jcnossen/dmf/README.md

# dmf
Prototype for electrowetting and digital microfluidics
