jcnossen/dmf/dmf.brd

## EAGLE design dmf.brd (2015-10-09)

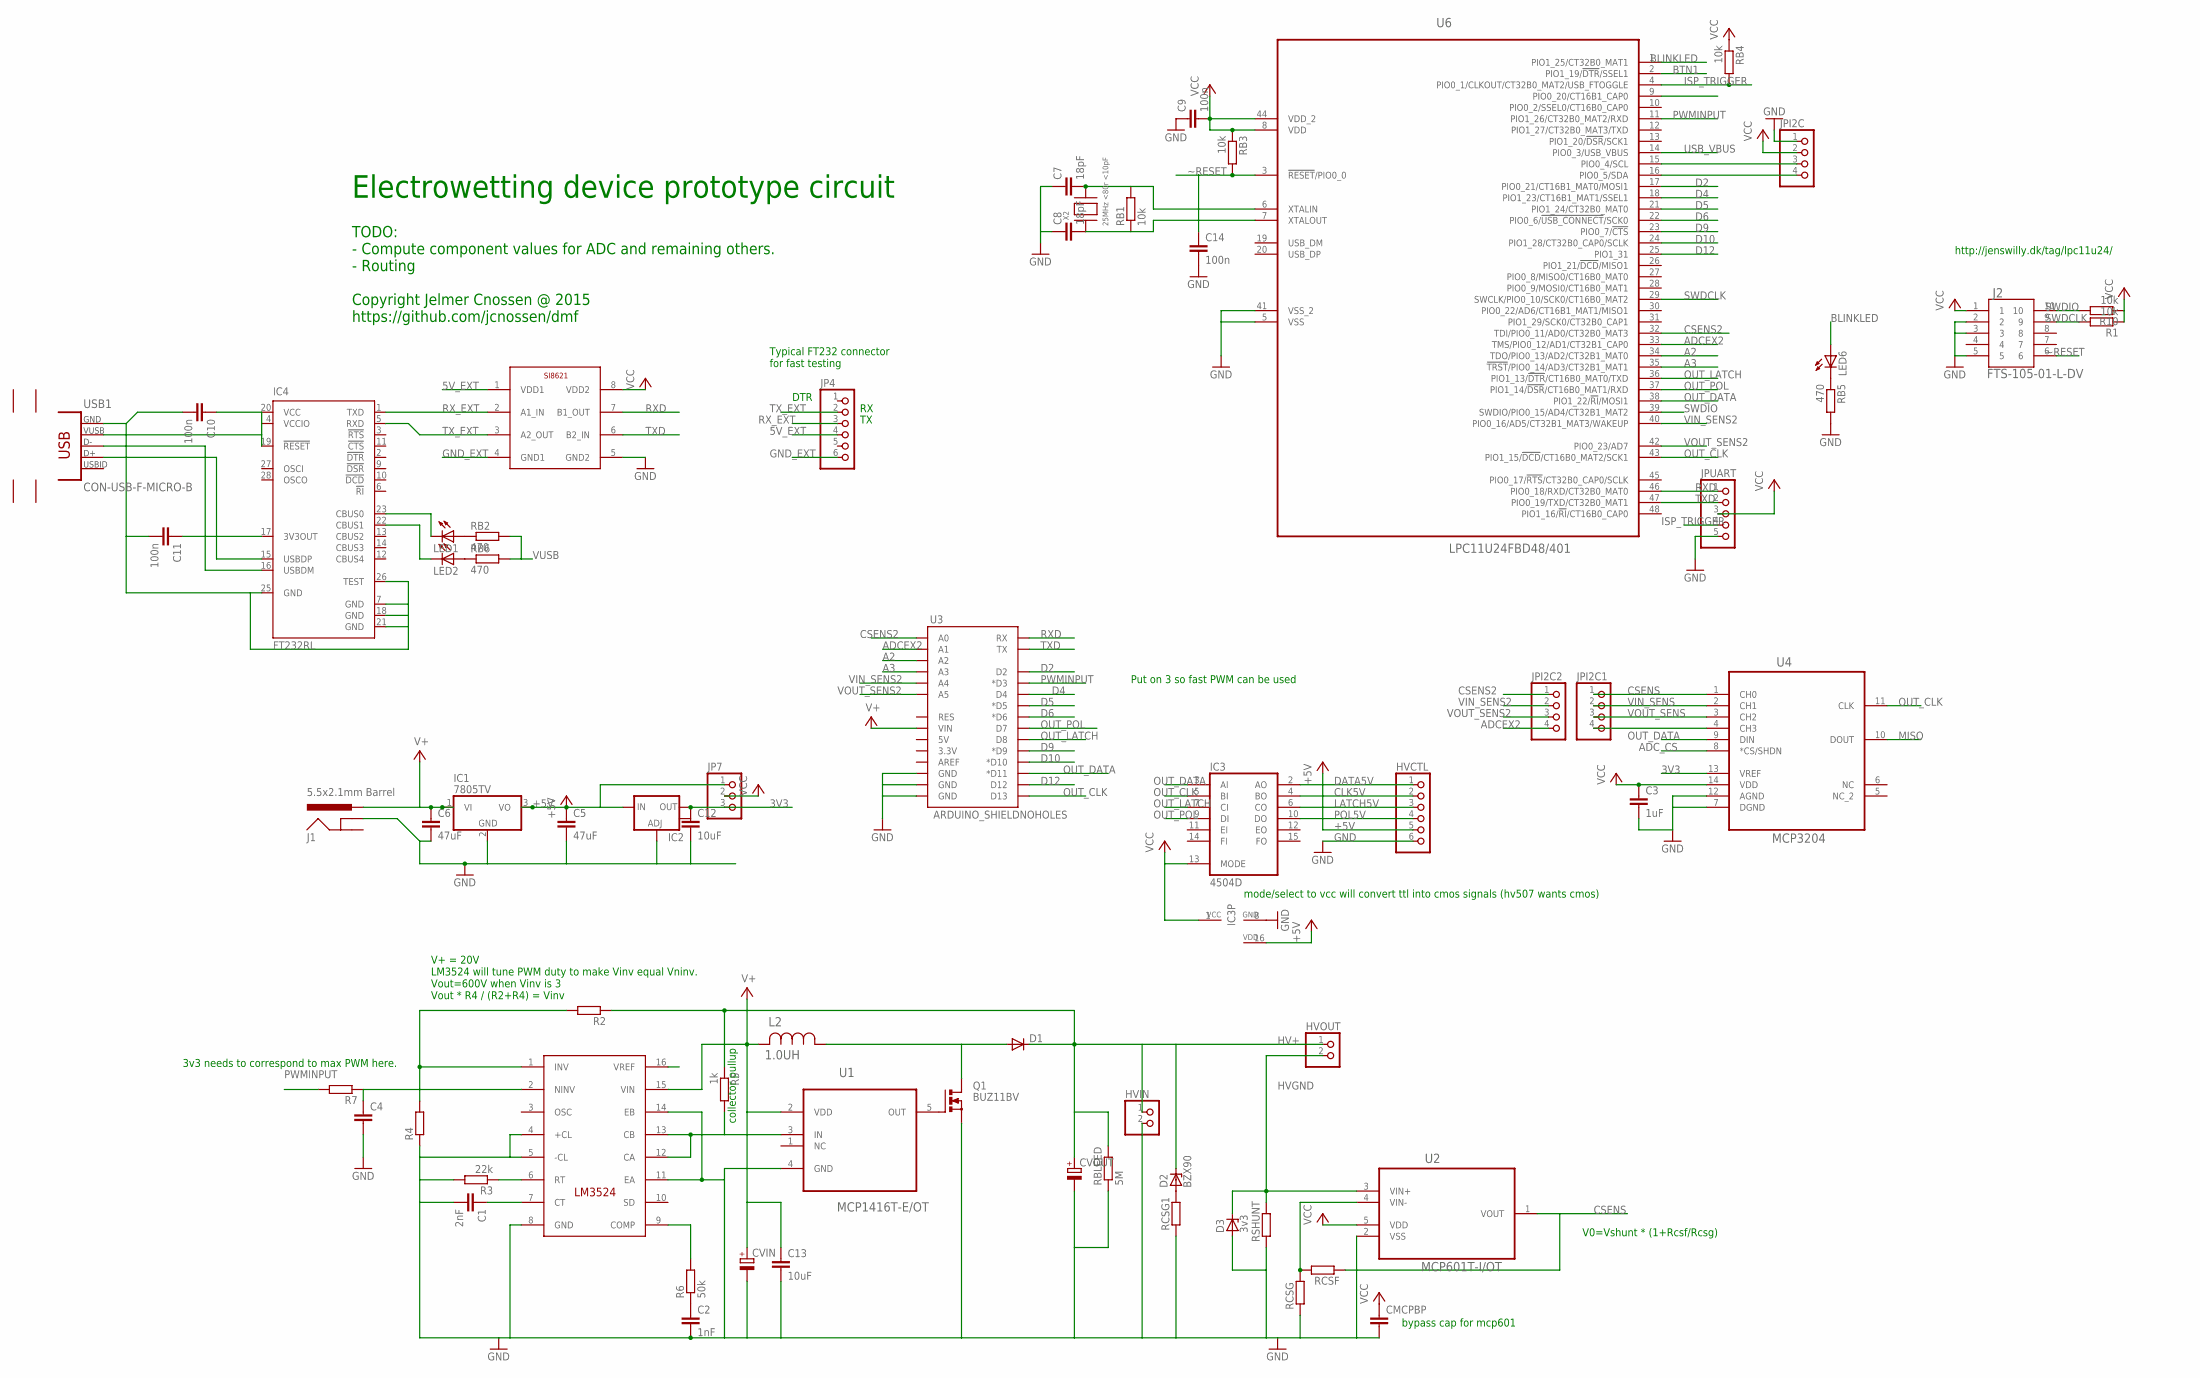
[picture p1: schematic dmf.sch, sheet 1]

Parts:
C1: 2nF; C0805
C2: 1nF; C0805
C3: 1uF; C0805
C4: C-EUC0805; C0805
C5, C6: 47uF; C1206
C7, C8: 18pF; C0805
C9, C10, C11, C14: 100n; C0805
C12: 10uF; C1206
C13: 10uF; C0805
CMCPBP: C-EUC0805; C0805
CVIN: CPOL-EUE7.5-18; E7,5-18
CVOUT: CPOL-EUE7.5-18; E7,5-18
D1: DIODE-SMB; SMB
D2: BZX90; DO34Z7
D3: 3v3; SMB
HVCTL: PINHD-1X06_2.54-S; 1X06-S
HVIN: PINHD-1X02_2.54; 1X02
HVOUT: PINHD-1X02_2.54; 1X02
IC1: 7805TV; TO220V
IC2: V_REG_LM1117SOT223; SOT223
IC3: 4504D; SO16
IC4: FT232RL; SSOP28
J1: 5.5x2.1mm Barrel; POWER_JACK_SMD
J2: FTS-105-01-L-DV; SAMTEC_FTS-105-01-L-DV
JP4: PINHD-1X06_2.54-S; 1X06-S
JP7: PINHD-1X03_2.54-S; 1X03-S
JPI2C, JPI2C1, JPI2C2: PINHD-1X04_2.54-S; 1X04-S
JPUART: PINHD-1X05_2.54-S; 1X05-S
L2: 1.0UH; IND_ELL6XH
LED1, LED2, LED6: LEDCHIP-LED0805; CHIP-LED0805
Q1: BUZ11BV; TO220BV
R1, R10: 10k; R0603
R2, R4, R7: R-EU_R0603; R0603
R3: 22k; R0603
R5: 1k; R0603
R6: 50k; R0603
RB1, RB3, RB4: 10k; R0603
RB2, RB6: 470; R0603
RB5: 470; R0402
RBLEED: 5M; R1206
RCSF: R-EU_R0603; R0603
RCSG: R-EU_R0603; R0603
RCSG1: R-EU_R1206; R1206
RSHUNT: R-EU_R1206; R1206
U1: MCP1416T-E/OT; SOT95P270X145-5N
U2: MCP601T-I/OT; SOT95P320X145-5N
U3: ARDUINO_SHIELDNOHOLES; DUEMILANOVE_SHIELD_NOHOLES
U4: MCP3204; SOIC127P600X175-14N
U6: LPC11U24FBD48/401; QFP50P900X900X160-48N
U$1: LM3524; SO16
U$2: SI8621AB; SO8
USB1: CON-USB-F-MICRO-B; CONN_USB_MICRO-B
X2: 25MHz <80r <10pF; NX5032

Connections:
3V3: C12.1, IC2.2 (OUT), JP7.3, U4.13 (VREF)
5V_EXT: JP4.4, U$2.1 (VDD1)
+5V: C5.1, HVCTL.5, IC1.3 (VO), IC2.3 (IN), IC3.16 (VDD), JP7.1
A2: U3.A2, U6.34 (TDO/PIO0_13/AD2/CT32B1_MAT0)
A3: U3.A3, U6.35 (!TRST!/PIO0_14/AD3/CT32B1_MAT1)
ADCEX: JPI2C1.4, U4.4 (CH3)
ADCEX2: JPI2C2.4, U3.A1, U6.33 (TMS/PIO0_12/AD1/CT32B1_CAP0)
ADC_CS: U4.8 (*CS/SHDN)
BLINKLED: LED6.A, U6.1 (PIO1_25/CT32B0_MAT1)
BTN1: U6.2 (PIO1_19/!DTR!/SSEL1)
CLK5V: HVCTL.2, IC3.4 (BO)
COLLECTOR: R5.2, U1.3 (IN), U$1.12 (CA), U$1.13 (CB)
CSENS: JPI2C1.1, RCSF.1, U2.1 (VOUT), U4.1 (CH0)
CSENS2: JPI2C2.1, U3.A0, U6.32 (TDI/PIO0_11/AD0/CT32B0_MAT3)
D2: U3.D2, U6.17 (PIO0_21/CT16B1_MAT0/MOSI1)
D4: U3.D4, U6.18 (PIO1_23/CT16B1_MAT1/SSEL1)
D5: U3.D5 (*D5), U6.21 (PIO1_24/CT32B0_MAT0)
D6: U3.D6 (*D6), U6.22 (PIO0_6/!USB_CONNECT!/SCK0)
D9: U3.D9 (*D9), U6.23 (PIO0_7/!CTS)
D10: U3.D10 (*D10), U6.24 (PIO1_28/CT32B0_CAP0/SCLK)
D12: U3.D12, U6.25 (PIO1_31)
DATA5V: HVCTL.1, IC3.2 (AO)
GND: C1.2, C2.2, C3.2, C4.2, C5.2, C6.2, C7.1, C8.1, C9.1, C12.2, C13.2, C14.2, CMCPBP.2, CVIN.-, CVOUT.-, D3.A, HVCTL.6, HVIN.2, IC1.2 (GND), IC2.1 (ADJ), IC3.8 (GND), J1.GND (GNDBREAK), J2.2, J2.3, J2.5, JPI2C.1, JPUART.5, Q1.S, R3.2, R4.1, RB5.2, RBLEED.1, RCSG.1, RCSG1.1, RSHUNT.1, U1.4 (GND), U2.2 (VSS), U3.GND@0 (GND), U3.GND@1 (GND), U3.GND@2 (GND), U4.7 (DGND), U4.12 (AGND), U6.5 (VSS), U6.41 (VSS_2), U$1.4 (+CL), U$1.5 (-CL), U$1.8 (GND), U$1.11 (EA), U$1.14 (EB), U$2.5 (GND2)
GND_EXT: C10.2, C11.2, IC4.7 (GND), IC4.18 (GND), IC4.21 (GND), IC4.25 (GND), IC4.26 (TEST), JP4.6, U$2.4 (GND1), USB1.P5 (GND)
HV+: CVOUT.+, D1.C, D2.C, HVIN.1, HVOUT.1, R2.1, R5.1, RBLEED.2
HVGND: D3.C, HVOUT.2, RSHUNT.2, U2.3 (VIN+)
ISP_TRIGGER: JPUART.4, RB4.2, U6.4 (PIO0_1/CLKOUT/CT32B0_MAT2/USB_FTOGGLE)
LATCH5V: HVCTL.3, IC3.6 (CO)
MISO: U4.10 (DOUT)
unnamed: C2.1, R6.1
unnamed: C1.1, U$1.7 (CT)
unnamed: R2.2, R4.2, U$1.1 (INV)
unnamed: R3.1, U$1.6 (RT)
unnamed: R6.2, U$1.9 (COMP)
unnamed: D1.A, L2.1, Q1.D
unnamed: Q1.G, U1.5 (OUT)
unnamed: RCSF.2, RCSG.2, U2.4 (VIN-)
unnamed: D2.A, RCSG1.2
unnamed: C4.1, R7.1, U$1.2 (NINV)
unnamed: IC4.16 (USBDM), USB1.P2 (D-)
unnamed: IC4.15 (USBDP), USB1.P3 (D+)
unnamed: C11.1, IC4.17 (3V3OUT)
unnamed: IC4.23 (CBUS0), LED1.C
unnamed: IC4.22 (CBUS1), LED2.C
unnamed: LED1.A, RB2.1
unnamed: LED2.A, RB6.1
unnamed: C8.2, RB1.1, U6.7 (XTALOUT), X2.P$1
unnamed: LED6.C, RB5.1
unnamed: C7.2, RB1.2, U6.6 (XTALIN), X2.P$2
OUT_CLK: IC3.5 (BI), U3.D13, U4.11 (CLK), U6.43 (PIO1_15/!DCD!/CT16B0_MAT2/SCK1)
OUT_DATA: IC3.3 (AI), U3.D11 (*D11), U4.9 (DIN), U6.38 (PIO1_22/!RI!/MOSI1)
OUT_LATCH: IC3.7 (CI), U3.D8, U6.36 (PIO1_13/!DTR!/CT16B0_MAT0/TXD)
OUT_POL: IC3.9 (DI), U3.D7, U6.37 (PIO1_14/!DSR!/CT16B0_MAT1/RXD)
POL5V: HVCTL.4, IC3.10 (DO)
PWMINPUT: R7.2, U3.D3 (*D3), U6.11 (PIO1_26/CT32B0_MAT2/RXD)
RXD: JPUART.1, U3.RX, U6.46 (PIO0_18/RXD/CT32B0_MAT0), U$2.7 (B1_OUT)
RX_EXT: IC4.1 (TXD), JP4.3, U$2.2 (A1_IN)
SCL: JPI2C.3, U6.15 (PIO0_4/SCL)
SDA: JPI2C.4, U6.16 (PIO0_5/SDA)
SWDCLK: J2.9, R1.2, U6.29 (SWCLK/PIO0_10/SCK0/CT16B0_MAT2)
SWDIO: J2.10, R10.2, U6.39 (SWDIO/PIO0_15/AD4/CT32B1_MAT2)
TXD: JPUART.2, U3.TX, U6.47 (PIO0_19/TXD/CT32B0_MAT1), U$2.6 (B2_IN)
TX_EXT: IC4.5 (RXD), JP4.2, U$2.3 (A2_OUT)
USB_VBUS: U6.14 (PIO0_3/USB_VBUS)
V+: C6.1, C13.1, CVIN.+, IC1.1 (VI), J1.VIN0 (PWR), L2.2, U1.2 (VDD), U3.VIN, U$1.15 (VIN)
VCC: C3.1, C9.2, CMCPBP.1, IC3.1 (VCC), IC3.13 (MODE), J2.1, JP7.2, JPI2C.2, JPUART.3, R1.1, R10.1, RB3.1, RB4.1, U2.5 (VDD), U4.14 (VDD), U6.8 (VDD), U6.44 (VDD_2), U$2.8 (VDD2)
VIN_SENS: JPI2C1.2, U4.2 (CH1)
VIN_SENS2: JPI2C2.2, U3.A4, U6.40 (PIO0_16/AD5/CT32B1_MAT3/WAKEUP)
VOUT_SENS: JPI2C1.3, U4.3 (CH2)
VOUT_SENS2: JPI2C2.3, U3.A5, U6.42 (PIO0_23/AD7)
VUSB: C10.1, IC4.4 (VCCIO), IC4.19 (!RESET), IC4.20 (VCC), RB2.2, RB6.2, USB1.P1 (VUSB)
~RESET: C14.1, J2.6, RB3.2, U6.3 (!RESET!/PIO0_0)

Notes on the sheet:
V0=Vshunt * (1+Rcsf/Rcsg)
bypass cap for mcp601
V+ = 20V LM3524 will tune PWM duty to make Vinv equal Vninv. Vout=600V when Vinv is 3 Vout * R4 / (R2+R4) = Vinv
3v3 needs to correspond to max PWM here.
Put on 3 so fast PWM can be used
mode/select to vcc will convert ttl into cmos signals (hv507 wants cmos)
DTR
Typical FT232 connector for fast testing
http://jenswilly.dk/tag/lpc11u24/
collector pullup
TODO: - Compute component values for ADC and remaining others. - Routing Copyright Jelmer Cnossen @ 2015 https://github.com/jcnossen/dmf
Electrowetting device prototype circuit

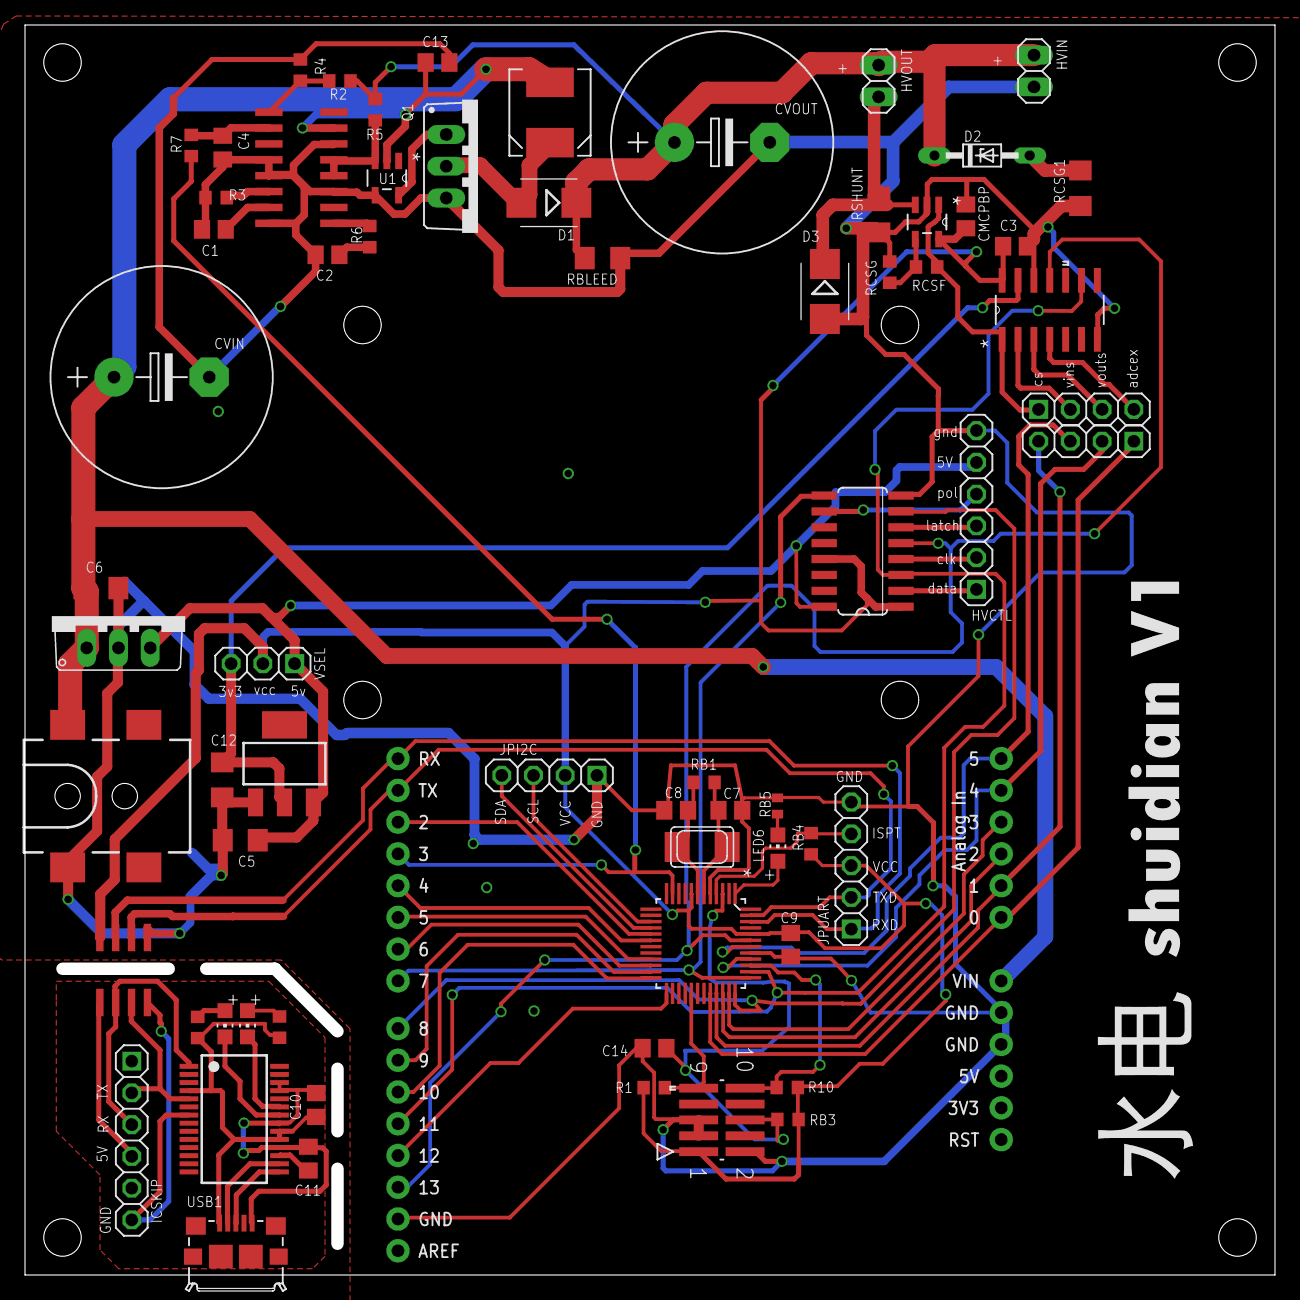
[picture p2: board dmf.brd from above]

Board: 2 copper layers, 100.0 x 100.0 mm, 68 parts (0 on the bottom side), 68 nets.
