jcnossen/dmf/sample64pin.brd

## EAGLE design sample64pin.brd (2015-10-09)

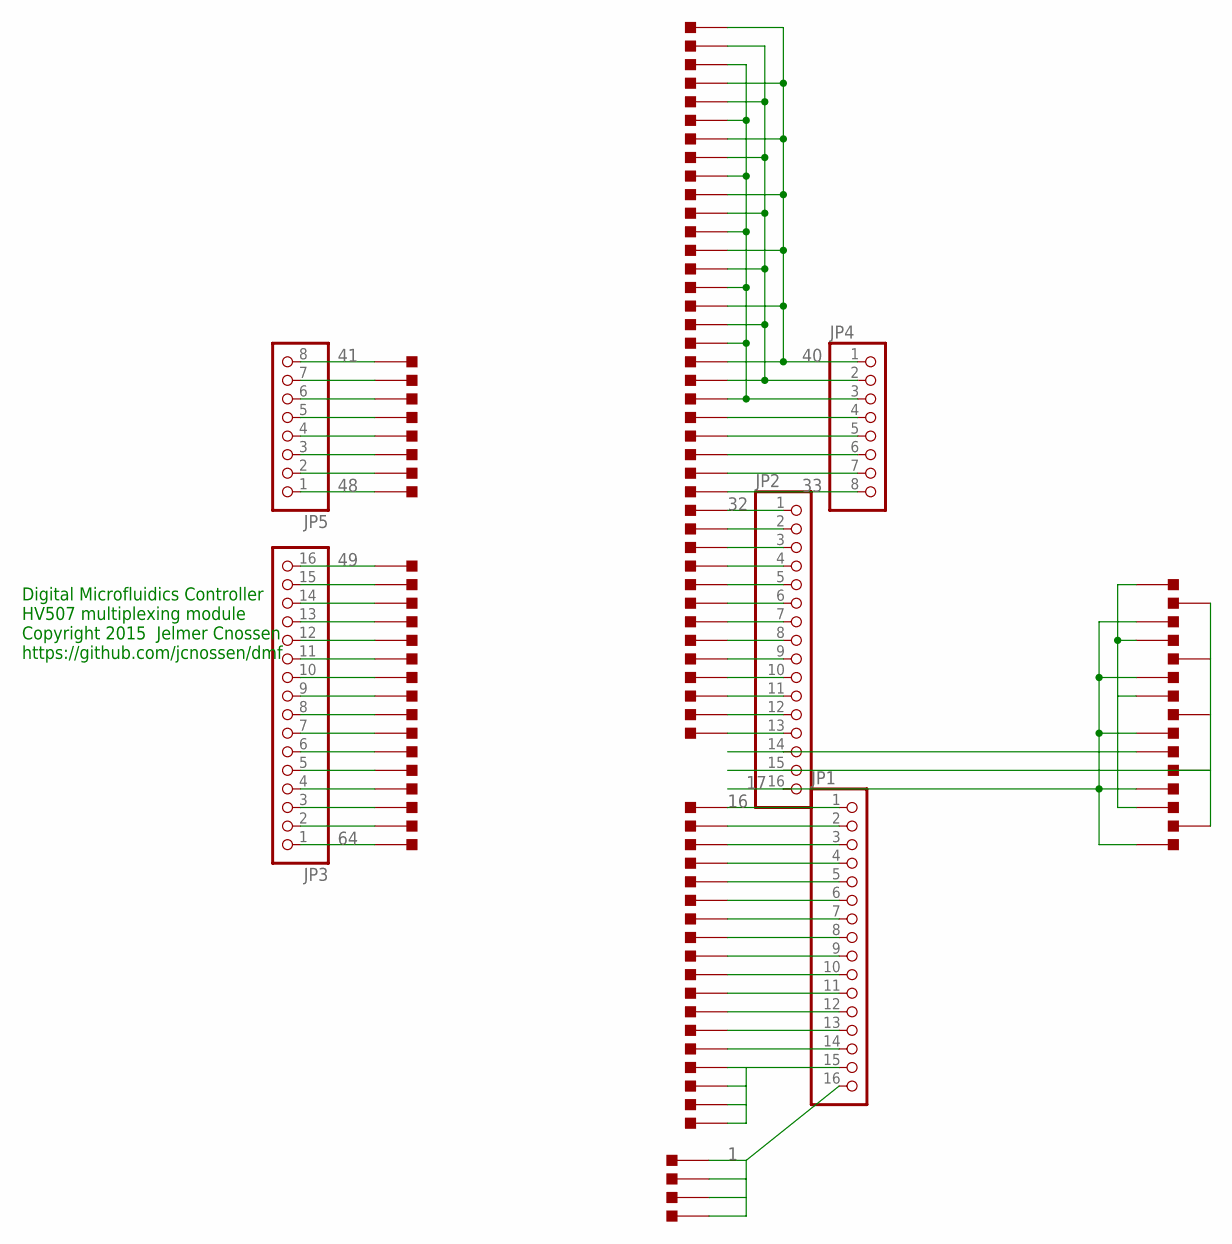
[picture p3: schematic sample64pin.sch]

Parts:
JP1, JP2, JP3: PINHD-1X16_2.54-S; 1X16-S
JP4, JP5: PINHD-1X08_2.54-S; 1X08-S
U$1, U$2, U$3, U$4, U$5, U$6, U$7, U$8, U$9, U$10, U$11, U$12, U$13, U$14, U$15, U$16, U$17, U$18, U$19, U$20, U$21, U$22, U$23, U$24, U$25, U$26, U$27, U$28, U$29, U$30, U$31, U$32, U$33, U$34, U$35, U$36, U$37, U$38, U$39, U$40, U$41, U$42, U$43, U$44, U$45, U$46, U$47, U$48, U$49, U$50, U$51, U$52, U$53, U$54, U$55, U$56, U$57, U$58, U$59, U$60, U$61, U$62, U$63, U$64, U$65, U$66, U$67, U$68, U$69, U$70, U$71, U$72, U$73, U$74, U$75, U$76, U$77, U$78, U$79, U$80, U$81, U$82, U$83, U$84, U$85, U$86, U$87, U$88, U$89, U$90, U$91, U$92, U$93, U$94, U$95, U$96, U$97, U$98, U$99, U$100: ELECTRODE

Connections:
1: JP1.16, U$46.P$2, U$47.P$2, U$48.P$2, U$64.P$2
16: JP1.1, U$49.P$2
17: JP2.16, U$67.P$2, U$70.P$2, U$73.P$2, U$76.P$2, U$79.P$2
32: JP2.1, U$33.P$2
33: JP4.8, U$32.P$2
40: JP4.1, U$1.P$2, U$80.P$2, U$83.P$2, U$86.P$2, U$89.P$2, U$92.P$2, U$95.P$2
41: JP5.8, U$4.P$2
48: JP5.1, U$11.P$2
49: JP3.16, U$12.P$2
64: JP3.1, U$27.P$2
unnamed: JP2.14, U$65.P$2, U$68.P$2, U$71.P$2, U$74.P$2, U$77.P$2
unnamed: JP1.2, U$50.P$2
unnamed: JP1.3, U$51.P$2
unnamed: JP1.4, U$52.P$2
unnamed: JP1.5, U$53.P$2
unnamed: JP1.6, U$54.P$2
unnamed: JP1.7, U$55.P$2
unnamed: JP1.8, U$56.P$2
unnamed: JP1.9, U$57.P$2
unnamed: JP1.10, U$58.P$2
unnamed: JP1.11, U$59.P$2
unnamed: JP1.12, U$60.P$2
unnamed: JP1.13, U$61.P$2
unnamed: JP1.14, U$62.P$2
unnamed: JP1.15, U$63.P$2, U$98.P$2, U$99.P$2, U$100.P$2
unnamed: JP2.15, U$66.P$2, U$69.P$2, U$72.P$2, U$75.P$2, U$78.P$2
unnamed: JP2.2, U$34.P$2
unnamed: JP2.3, U$35.P$2
unnamed: JP2.4, U$36.P$2
unnamed: JP2.5, U$37.P$2
unnamed: JP2.6, U$38.P$2
unnamed: JP2.7, U$39.P$2
unnamed: JP2.8, U$40.P$2
unnamed: JP2.9, U$41.P$2
unnamed: JP2.10, U$42.P$2
unnamed: JP2.11, U$43.P$2
unnamed: JP2.12, U$44.P$2
unnamed: JP2.13, U$45.P$2
unnamed: JP3.2, U$26.P$2
unnamed: JP3.3, U$25.P$2
unnamed: JP3.4, U$24.P$2
unnamed: JP3.5, U$23.P$2
unnamed: JP3.6, U$22.P$2
unnamed: JP3.7, U$21.P$2
unnamed: JP3.8, U$20.P$2
unnamed: JP3.9, U$19.P$2
unnamed: JP3.10, U$18.P$2
unnamed: JP3.11, U$17.P$2
unnamed: JP3.12, U$16.P$2
unnamed: JP3.13, U$15.P$2
unnamed: JP3.14, U$14.P$2
unnamed: JP3.15, U$13.P$2
unnamed: JP4.2, U$2.P$2, U$81.P$2, U$84.P$2, U$87.P$2, U$90.P$2, U$93.P$2, U$96.P$2
unnamed: JP4.3, U$3.P$2, U$82.P$2, U$85.P$2, U$88.P$2, U$91.P$2, U$94.P$2, U$97.P$2
unnamed: JP4.4, U$28.P$2
unnamed: JP4.5, U$29.P$2
unnamed: JP4.6, U$30.P$2
unnamed: JP4.7, U$31.P$2
unnamed: JP5.2, U$10.P$2
unnamed: JP5.3, U$9.P$2
unnamed: JP5.4, U$8.P$2
unnamed: JP5.5, U$7.P$2
unnamed: JP5.6, U$6.P$2
unnamed: JP5.7, U$5.P$2

Notes on the sheet:
Digital Microfluidics Controller HV507 multiplexing module Copyright 2015 Jelmer Cnossen https://github.com/jcnossen/dmf

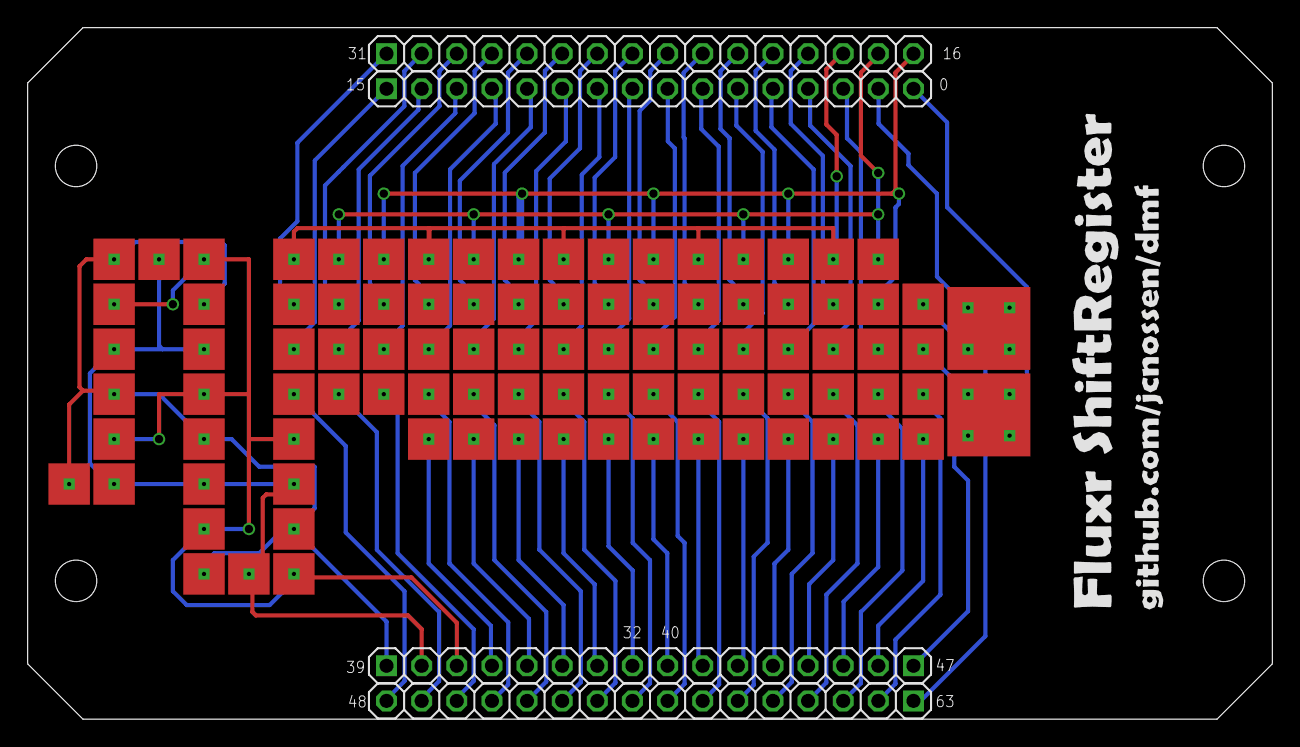
[picture p4: board sample64pin.brd from above]

Board: 2 copper layers, 90.0 x 50.0 mm, 105 parts (0 on the bottom side), 64 nets.
