jcnossen/dmf/hv507_connector.brd

## EAGLE design hv507_connector.brd (2015-10-06)

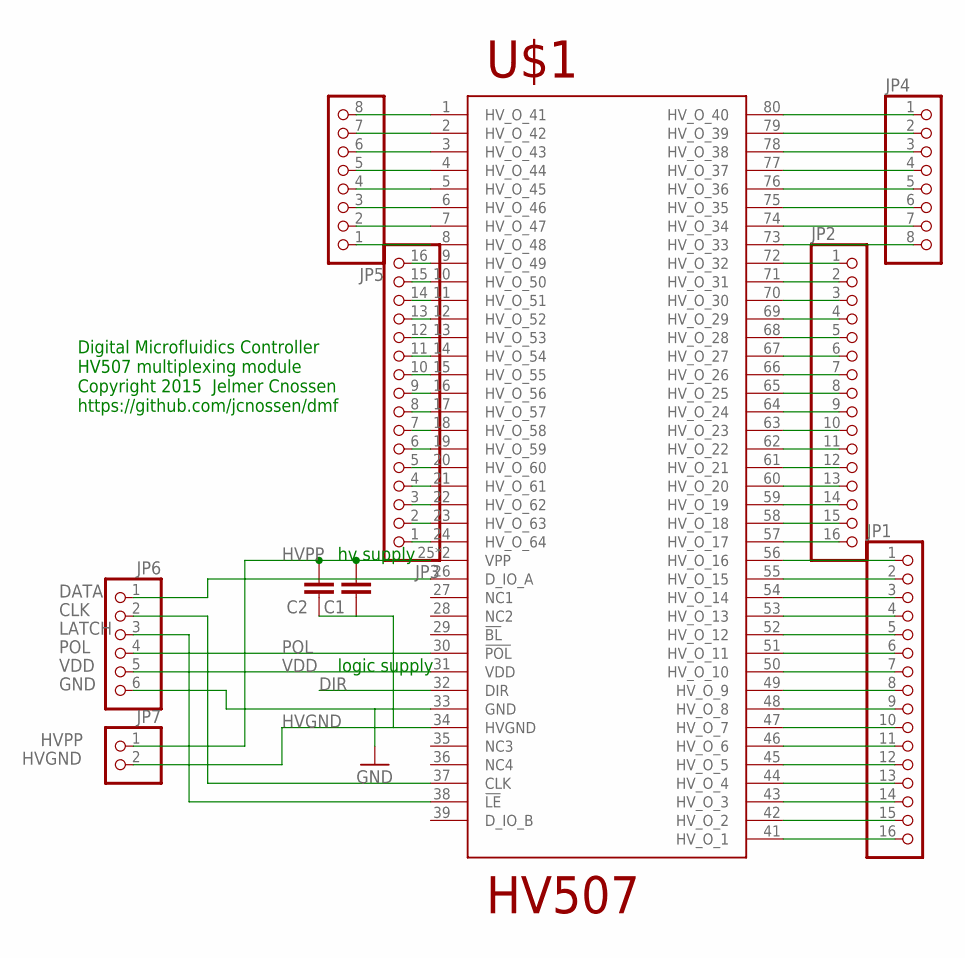
[picture p5: schematic hv507_connector.sch]

Parts:
C1: C-EUC1812; C1812
C2: C-EUC1206; C1206
JP1, JP2, JP3: PINHD-1X16_2.54-S; 1X16-S
JP4, JP5: PINHD-1X08_2.54-S; 1X08-S
JP6: PINHD-1X06_2.54-S; 1X06-S
JP7: PINHD-1X02_2.54-S; 1X02-S
U$1: HV507; HV507PG-G

Connections:
1: JP1.16, U$1.41 (HV_O_1)
16: JP1.1, U$1.56 (HV_O_16)
17: JP2.16, U$1.57 (HV_O_17)
32: JP2.1, U$1.72 (HV_O_32)
33: JP4.8, U$1.73 (HV_O_33)
40: JP4.1, U$1.80 (HV_O_40)
41: JP5.8, U$1.1 (HV_O_41)
48: JP5.1, U$1.8 (HV_O_48)
49: JP3.16, U$1.9 (HV_O_49)
64: JP3.1, U$1.24 (HV_O_64)
CLK: JP6.2, U$1.37 (CLK)
DATA: JP6.1, U$1.26 (D_IO_A)
DIR: U$1.32 (DIR)
GND: JP6.6, U$1.33 (GND)
HVGND: C1.1, C2.1, JP7.2, U$1.34 (HVGND)
HVPP: C1.2, C2.2, JP7.1, U$1.25 (VPP), U$1.40 (VPP)
LATCH: JP6.3, U$1.38 (!LE)
unnamed: JP1.2, U$1.55 (HV_O_15)
unnamed: JP1.3, U$1.54 (HV_O_14)
unnamed: JP1.4, U$1.53 (HV_O_13)
unnamed: JP1.5, U$1.52 (HV_O_12)
unnamed: JP1.6, U$1.51 (HV_O_11)
unnamed: JP1.7, U$1.50 (HV_O_10)
unnamed: JP1.8, U$1.49 (HV_O_9)
unnamed: JP1.9, U$1.48 (HV_O_8)
unnamed: JP1.10, U$1.47 (HV_O_7)
unnamed: JP1.11, U$1.46 (HV_O_6)
unnamed: JP1.12, U$1.45 (HV_O_5)
unnamed: JP1.13, U$1.44 (HV_O_4)
unnamed: JP1.14, U$1.43 (HV_O_3)
unnamed: JP1.15, U$1.42 (HV_O_2)
unnamed: JP2.2, U$1.71 (HV_O_31)
unnamed: JP2.3, U$1.70 (HV_O_30)
unnamed: JP2.4, U$1.69 (HV_O_29)
unnamed: JP2.5, U$1.68 (HV_O_28)
unnamed: JP2.6, U$1.67 (HV_O_27)
unnamed: JP2.7, U$1.66 (HV_O_26)
unnamed: JP2.8, U$1.65 (HV_O_25)
unnamed: JP2.9, U$1.64 (HV_O_24)
unnamed: JP2.10, U$1.63 (HV_O_23)
unnamed: JP2.11, U$1.62 (HV_O_22)
unnamed: JP2.12, U$1.61 (HV_O_21)
unnamed: JP2.13, U$1.60 (HV_O_20)
unnamed: JP2.14, U$1.59 (HV_O_19)
unnamed: JP2.15, U$1.58 (HV_O_18)
unnamed: JP3.2, U$1.23 (HV_O_63)
unnamed: JP3.3, U$1.22 (HV_O_62)
unnamed: JP3.4, U$1.21 (HV_O_61)
unnamed: JP3.5, U$1.20 (HV_O_60)
unnamed: JP3.6, U$1.19 (HV_O_59)
unnamed: JP3.7, U$1.18 (HV_O_58)
unnamed: JP3.8, U$1.17 (HV_O_57)
unnamed: JP3.9, U$1.16 (HV_O_56)
unnamed: JP3.10, U$1.15 (HV_O_55)
unnamed: JP3.11, U$1.14 (HV_O_54)
unnamed: JP3.12, U$1.13 (HV_O_53)
unnamed: JP3.13, U$1.12 (HV_O_52)
unnamed: JP3.14, U$1.11 (HV_O_51)
unnamed: JP3.15, U$1.10 (HV_O_50)
unnamed: JP4.2, U$1.79 (HV_O_39)
unnamed: JP4.3, U$1.78 (HV_O_38)
unnamed: JP4.4, U$1.77 (HV_O_37)
unnamed: JP4.5, U$1.76 (HV_O_36)
unnamed: JP4.6, U$1.75 (HV_O_35)
unnamed: JP4.7, U$1.74 (HV_O_34)
unnamed: JP5.2, U$1.7 (HV_O_47)
unnamed: JP5.3, U$1.6 (HV_O_46)
unnamed: JP5.4, U$1.5 (HV_O_45)
unnamed: JP5.5, U$1.4 (HV_O_44)
unnamed: JP5.6, U$1.3 (HV_O_43)
unnamed: JP5.7, U$1.2 (HV_O_42)
POL: JP6.4, U$1.30 (!POL)
VDD: JP6.5, U$1.31 (VDD)

Notes on the sheet:
logic supply
hv supply
Digital Microfluidics Controller HV507 multiplexing module Copyright 2015 Jelmer Cnossen https://github.com/jcnossen/dmf

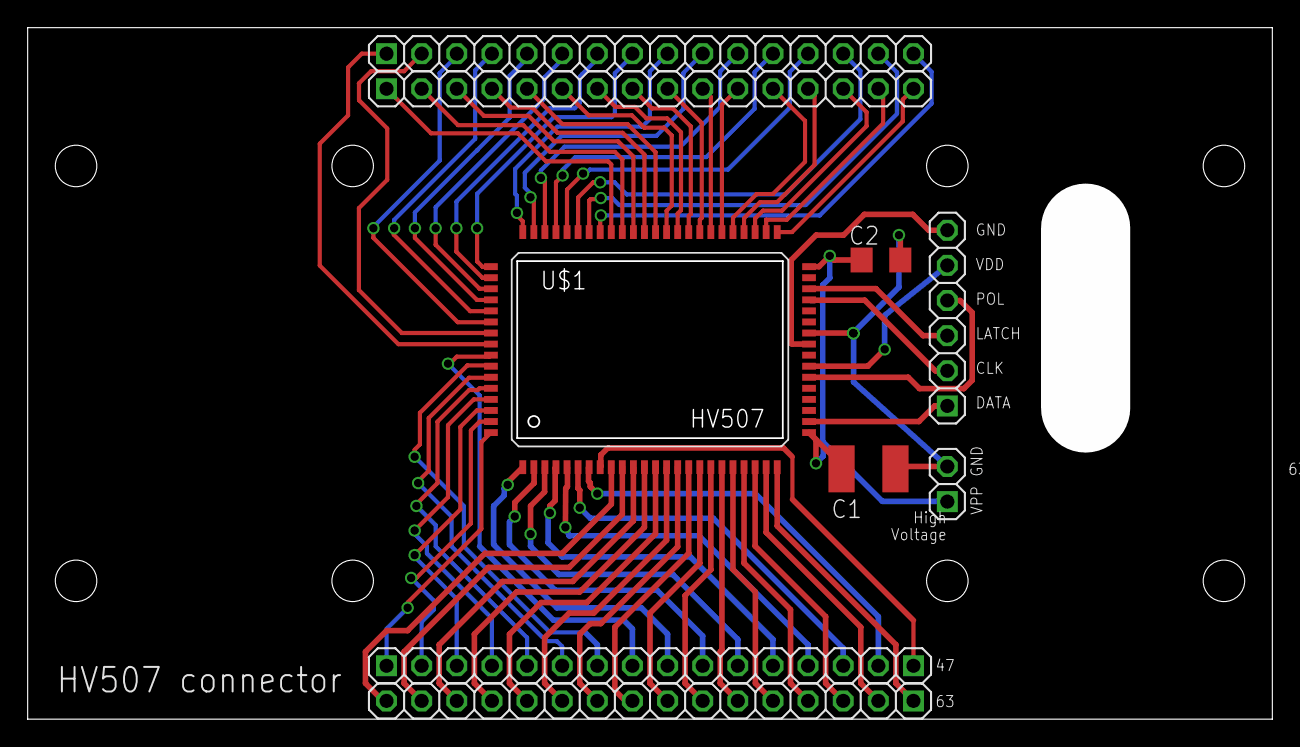
[picture p6: board hv507_connector.brd from above]

Board: 2 copper layers, 90.0 x 50.0 mm, 10 parts (0 on the bottom side), 72 nets.
