jcnossen/dmf/(commit log)

2015-09-22 * Eagle schematics upload
    [dmf.brd, dmf.sch, hv507_connector.brd, hv507_connector.sch]
2015-09-27 dmf.brd routing
    [dmf.brd, dmf.sch]
2015-10-06 * DMF board first iteration
    [dmf.brd, dmf.sch, hv507_connector.brd, hv507_connector.sch]
2015-10-09 * sample64pin
    [dmf.brd, dmf.sch, sample64pin.brd, sample64pin.sch]
